danny-andersen/baby-monitor/baby-cam/circuit-schematic.pdf

# 100RRed

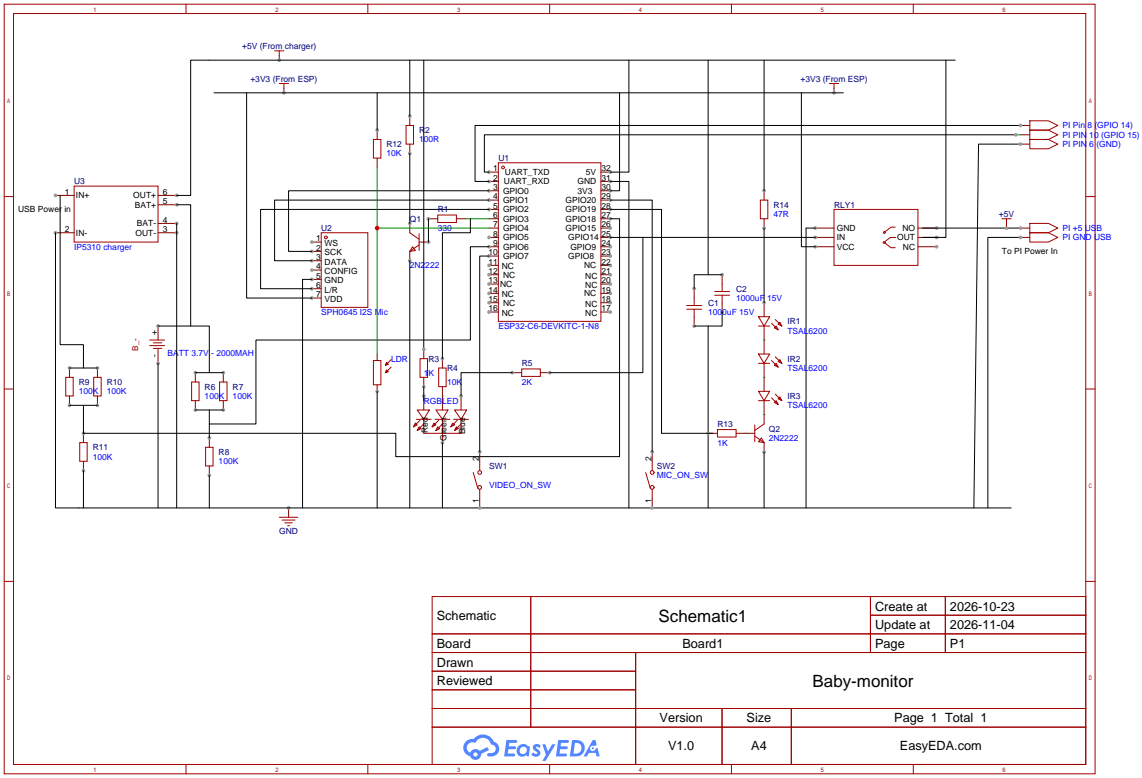
[picture p1: page 1]

To PI Power In

Schematic | Schematic1 | Create at | 2026-10-23

Update at | 2026-11-04

Board | Board1 | Page | P1
Drawn | | Baby-monitor
Reviewed

Version | Size | Page 1 Total 1
V1.0 | A4 | EasyEDA.com
