danny-andersen/baby-monitor/baby-cam/cam-ir-vero.pdf

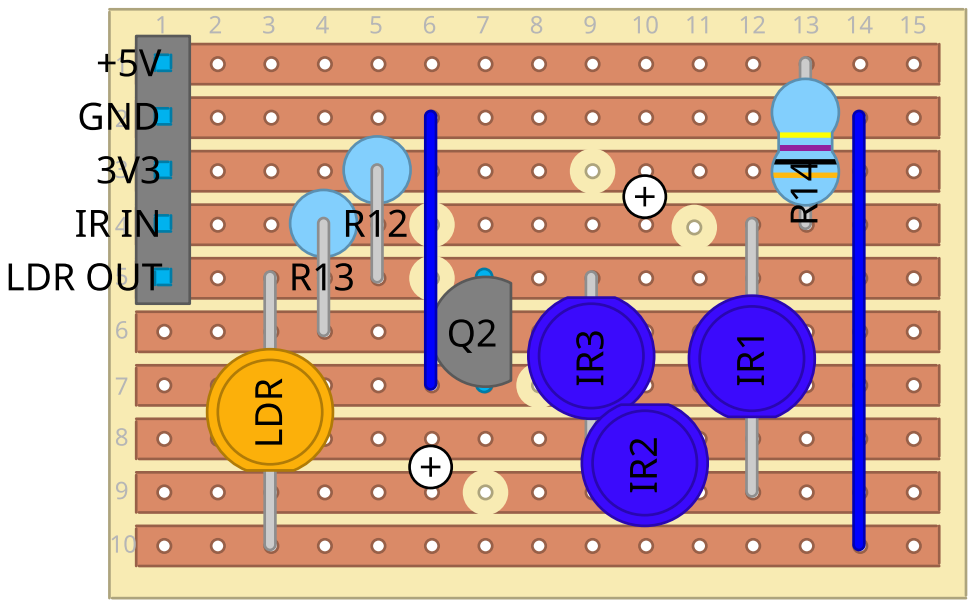
[picture p2: page 1]
