danny-andersen/baby-monitor/baby-cam/cam-main-vero.pdf

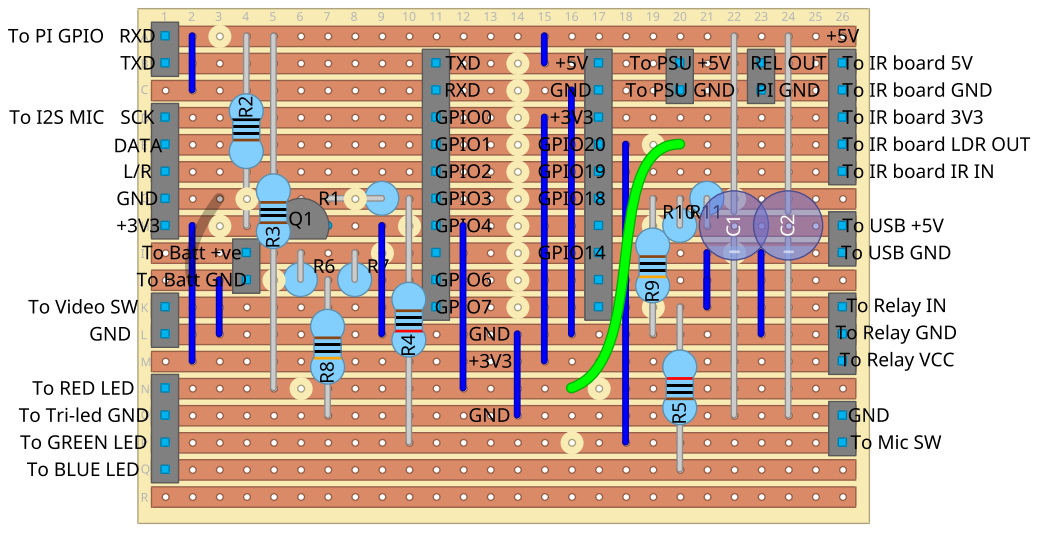
[picture p3: page 1]
