danny-andersen/baby-monitor/baby-cam/baby-cam-esp32/baby-cam-defs.h

#define DEBUG 1 // SET TO 0 TO REMOVE TRACES

#if DEBUG
#define D_Serial Serial
#define D_SerialBegin(...) Serial.begin(__VA_ARGS__)
#define D_print(...) Serial.print(__VA_ARGS__)
#define D_write(...) Serial.write(__VA_ARGS__)
#define D_println(...) Serial.println(__VA_ARGS__)
#define D_printf(...) Serial.printf(__VA_ARGS__)
#define D_flush() Serial.flush()
#else
#define D_Serial 1
#define D_SerialBegin(...)
#define D_print(...)
#define D_write(...)
#define D_println(...)
#define D_printf(...)
#define D_flush() 
#endif

//---PIN definitions----

// -------------------------
// I2S pins
// -------------------------
#define I2S_BCLK 0
#define I2S_DOUT 1
#define I2S_WS_LRCLK 2

// UART comms with PI
#define PI_SERIAL Serial1
#define PI_SERIAL_TX_PIN 16
#define PI_SERIAL_RX_PIN 17

// General Pins
#define CURRENT_DRAIN_PIN 3 // Keeps the battery protection from turning off the power when only the ESP is running
#define DARK_DET_PIN 4 // Determines the ambient light level - 0.5V very bright, 2V average 2.9V very dart
#define BATT_VOLTAGE_PIN 6
#define VIDEO_ON_PIN 7  //Pull this low to turn off the camera (by shutting down the PI)
#define PI_POWER_PIN 14 // Controls power to PI via a relay: low is on, high is off
#define CHARGING_PIN 18 //Set high if battery is charging, i.e. on external power
#define INFRARED_LED_DRIVER 19 //Output to drive Infra red LED lights on
#define MIC_ON_PIN 20 //Pull this low to turn off the microphone


// WiFi
static const uint32_t WIFI_TIMEOUT_MS = 10000;
static const uint32_t NEW_WIFI_TIMEOUT_MS = 20000;
static const uint8_t MAX_NETWORKS = 10;
#define WIFI_CHECK_INTERVAL 10000 // Interval of 10 second (1000 ms)
WiFiMulti wifiMulti;
WebServer server(8080);
unsigned long lastWifiCheckMillis = 0;
struct WiFiCredential
{
    String ssid;
    String password;
};
std::vector<WiFiCredential> networks;
bool configAPActive = false;

//Power thresholds
#define VIDEO_ON_THRESHOLD 60
#define VIDEO_OFF_THRESHOLD 35
#define POWER_LOW_THRESHOLD 20

//Deep sleep timings
#define uS_TO_S_FACTOR 1000000ULL /* Conversion factor for micro seconds to seconds */
#define TIME_TO_SLEEP  60          /* Time ESP32 will go to sleep (in seconds) */

bool wifi_connected = false; //Whether we have wifi or not
int current_batt_perc = 0;  // Currently calculated battery percentage
float current_batt_volts = 0.0;

bool video_power = false; //Video off until PI is powered on
bool video_on_requested = false; //Wait for the video on to be requested from the monitor
bool video_off_requested = false; //Turn off video if on
bool video_sw = true; //Whether the Video switch is set to on or off
bool mic_power = true; //Mic power is always on until power below low threshold
bool mic_sw = true; //Whether the Mic switch is set to on or off
volatile uint32_t audioClients = 0; //Number of audio clients connected to control start / stop of BLE

int charging = 0; //Whether powered externally or not
int drain_power = 0; //Whether the circuit to put an extra power load on is on

//INFRA RED LED LIGHT thresholds (0 is pitch black, 100 is very bright)
#define INFRARED_ON_THRESHOLD 20
#define INFRARED_OFF_THRESHOLD 35

int light_level = 0; //Level of the ambient light (0-100)
bool infrared_lights_on = false; //Whether the led lights are on or off

String audio_ip = "0.0.0.0"; //Not set
String video_ip = "0.0.0.0";
bool request_pi_addr = false; //Set to true when PI is UP

//Bluetooth 
NimBLEServer* bleServer = nullptr;
NimBLEService* bleService = nullptr;
NimBLECharacteristic* ipStatusChar = nullptr;

bool ble_on = false;
#define BLE_ON_MIN_TIME 30000 //BLE minimum on time 
uint32_t ble_on_time = 0; //Ensure BLE is turned on for a period, otherwise it causes a core dump

//PI serial comms related

#define PI_REQUEST_TIME 10000 /* How often to send a status check to the PI */
#define PI_SHUTDOWN_DELAY 20000  /* Time allowed for PI to shutdown */
#define PI_RESPONSE_TIME 5000 /* Time allowed for PI to respond to a command*/ 

enum PiStatus {
  UNKNOWN,
  POWERED_OFF,
  BOOTING,
  NO_RESPONSE,
  UP,
  SHUTDOWN_REQUESTED,
  SHUTTING_DOWN,
  SHUTDOWN
};

enum PiStatus pi_status = POWERED_OFF;   //State of PI
String camera_status = "Unknown"; //State of camera service running on the PI
unsigned long pi_shutdown_time = 0; //Time the PI responded to the shutdown
unsigned long pi_shutdown_request_time; //Time the PI was told to shutdown
unsigned long last_req_time = 0;  //Time last request was sent
unsigned long last_status_time = 0;  //Time last status command was sent

#if DEBUG
String pi_status_str() {
  String status_str = "";
  switch(pi_status) {
    case UNKNOWN:
      status_str = "UNKNOWN";
      break;
    case POWERED_OFF:
      status_str = "POWERED_OFF";
      break;
    case BOOTING:
      status_str = "BOOTING";
      break;
    case NO_RESPONSE:
      status_str = "NO_RESPONSE";
      break;
    case UP:
      status_str = "UP";
      break;
    case SHUTDOWN_REQUESTED:
      status_str = "SHUTDOWN_REQUESTED";
      break;
    case SHUTTING_DOWN:
      status_str = "SHUTTING_DOWN";
      break;
  }
  return status_str;
}
#else
String pi_status_str() {}
#endif

String pi_status_desc() {
  String status_str = "";
  switch(pi_status) {
    case UNKNOWN:
    case POWERED_OFF:
      if (current_batt_perc <= VIDEO_ON_THRESHOLD) {
        status_str = "powered off (low battery)";
      } 
      else {
        status_str = "powered off";
      }
      break;
    case BOOTING:
      status_str = "starting up";
      break;
    case NO_RESPONSE:
      status_str = "temporarily unavailable";
      break;
    case UP:
      if (camera_status != "") {
        status_str = camera_status;
      }
      else {
        status_str = "available";
      }
      break;
    case SHUTTING_DOWN:
    case SHUTDOWN_REQUESTED:
      status_str = "stopping";
      break;
  }
  return status_str;
}
