danny-andersen/baby-monitor/(commit log)

2026-10-02 Added shutdown button
2026-10-08 Corrected camera down/up logic and motion.service root definition
2026-10-11 Added battery % calc to baby-cam root page
2026-10-12 Added power_control function to control what is powered based on battery voltage
2026-10-12 Added test sketch for relay control
2026-10-13 Corrected batt % readings and extended the sample average
2026-10-13 Removed video on/off button
2026-10-13 Added volts to status page
2026-10-13 Moved power control pins to header
2026-10-13 Created service and script to monitor camera controllers
2026-10-13 Change PI power down threshold to 35%
2026-10-14 Added deep sleep when power low and corrected json string
2026-10-14 Added battery status icon
2026-10-14 Tweak to PI power threshold and batt volts factor
2026-10-14 Script to extract time and battery volts as a csv from the monitor script
2026-10-17 Working serial commands and moved camera to native picamera2 and python http server for better framerate
2026-10-18 Added camera service status checking
2026-10-20 Added charging sensor and icon. Also changed push buttons to use icons, rather than words
2026-10-21 Titivated the buttons and colours
2026-10-23 Added low light detection and Infra red LED driver
2026-10-23 First draft of circuit diagram
2026-10-28 Added BLE discovery of audio/status ip address and added web status reporting of video ip address rx from PI camera. Note: BLE introduces delays in audio streaming that causes dead spots in the playb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
2026-11-01 Require monitor to request video feed when powered on
2026-11-01 Send power off camera when monitor powering off
2026-11-01 Added switches to turn videp + mic off
2026-11-02 Minor fixes and added switch status to status
2026-11-04 Created vero layout for main board
2026-11-05 Added IR board
2026-11-05 Added PI GND socket
2026-11-07 Changes due to size of XH sockets
2026-11-10 IR board labels incorrect
2026-11-11 Added drill holes for IR board
2026-11-12 Trigger shutdown timer if PI not in UP state
